sjpiper145/GlowStitch/LED Strips Crown Headband Project.pdf

Lorem ipsum dolor sit amet, consectetuer adipiscing elit,sed diam nonummy

Maker
Queen

+

These clips act as a switch. When connected, it brings power from the battery to the lights!

Conductive Fabric tape acts as the wires of this project.

+

Use a tape measure to measure
your head. Cut a strip of fabric the same length to make sure it ts around your head. Add notches and shapes to make it look like a crown!

Lay down the conductive tape
into rails that will connect to the LEDs and to the battery.

Lay out the LED strips and battery in
your desired spot. Use more conductive tape to secure these in place.

Touch the ends of the battery tape against the LED Strip connected tape to test the circuit. The lights should come on.

Hand stitch or hammer in the snap fastners in place to act as the switch in the circuit. Finished!

## Step 1

## Step 2

## Step 3

## Step 4

## Step 5

If not, check for
shorts by making sure any positive sides don’t touch negative sides.

# CROWN HEAD BAND

# WEARABLE TECH PROJECT #1

## Find more projects and ideas at

## bit.ly/3pN5qk9

+
