sjpiper145/GlowStitch/LED Strips Glow Bag Project.pdf

Lorem ipsum dolor sit amet, consectetuer adipiscing elit,sed diam nonummy

Maker
Queen

Liven up an old bag or sew a new bag with decorations and light up electronics. The lights come on when the bag is shut!

Decorate the front with a
rainbow, ower or other design of your choice to nish o your project.
+

+

_

+

_

+

_

This clip acts as a switch. When connected, it brings power from the battery to the lights!

Use this circuit pattern either on the inside or outside of the bag. Use a layer of fabric over the top to protect the circuit if on the inside of the bag. Consider machine sewing to secure your circuit in place. Conductive tape will still function if painted during decoration.

Make sure the tape makes a good connection with the gold pads on the LEDs. Sandwich the LED pad between two layers of conductive tape if reversing the LEDs to shine through the fabric from the inside of the bag.

# gLOW BAG

# WEARABLE TECH PROJECT #2

## Find more projects and ideas at

# bit.ly/3pN5qk9
